jbeuckm/CR78-Controller/eagle/cr78_controller_layout.png

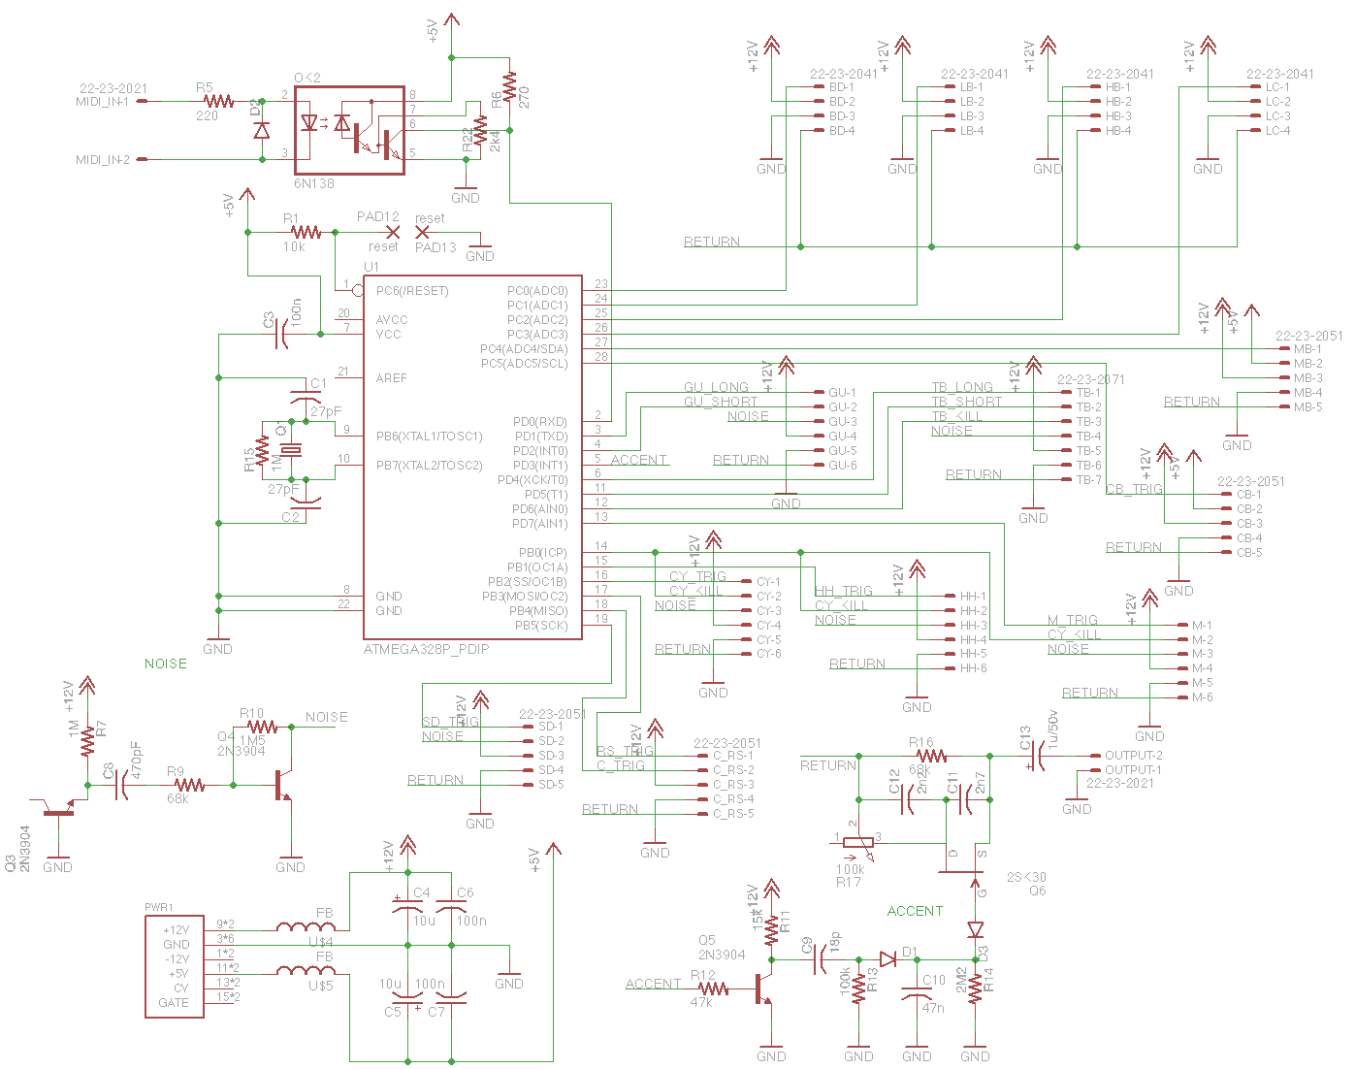
eagle/cr78_controller_layout.png
