jbeuckm/CR78-Controller/eagle/midi_to_cv.brd

## EAGLE design eagle/midi_to_cv.brd (2016-06-11)

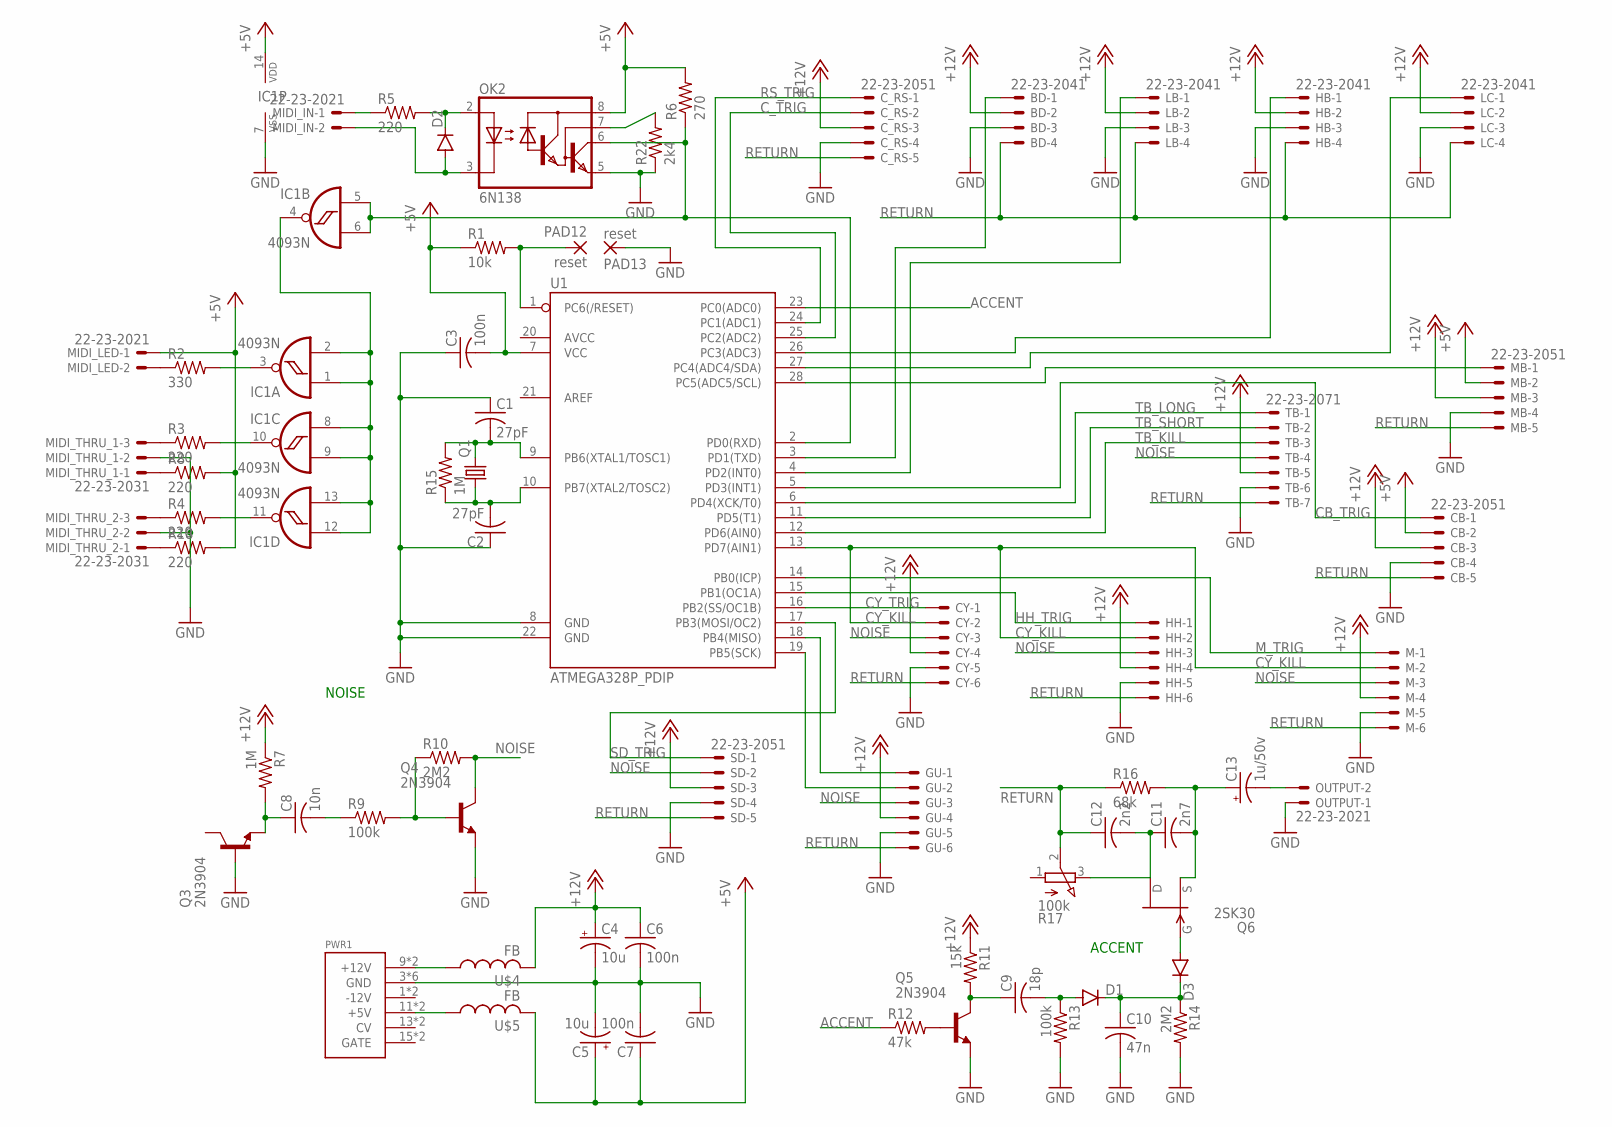
[picture p2: schematic midi_to_cv.sch]

Parts:
BD: 22-23-2041
C1, C2: 27pF; C025-040X050
C3: 100n; C025-040X050
C4, C5: 10u; B45181A
C6, C7: 100n; C050-024X044
C8: 10n; C025-040X050
C9: 18p; C050-025X075
C10: 47n; C025-040X050
C11: 2n7; C025-040X050
C12: 2n2; C025-040X050
C13: 1u/50v; B45181A
CB: 22-23-2051
CY: 22-23-2061
C_RS: 22-23-2051
D1: DIODEKIT; DIODE-1N4148-KIT
D2, D3: DIODE1N4148; DIODE-1N4148
GU: 22-23-2061
HB: 22-23-2041
HH: 22-23-2061
IC1: 4093N; DIL14
LB: 22-23-2041
LC: 22-23-2041
M: 22-23-2061
MB: 22-23-2051
MIDI_IN: 22-23-2021
MIDI_LED: 22-23-2021
MIDI_THRU_1, MIDI_THRU_2: 22-23-2031
OK2: 6N138; DIL08
OUTPUT: 22-23-2021
PAD12, PAD13: reset; 2,54/0,9
PWR1: POWER; POWER_16
Q1: CRYSTALHC49U-V; HC49U-V
Q3, Q4, Q5: 2N3904; TO92
Q6: 2SK30; TO92
R1: 10k; 0204/7
R2: 330; 0204/7
R3, R4, R5, R8, R18: 220; 0204/7
R6: 270; 0204/7
R7, R15: 1M; 0204/7
R9, R13: 100k; 0204/7
R10, R14: 2M2; 0204/7
R11: 15k; 0204/7
R12: 47k; 0207/12
R16: 68k; 0204/7
R17: 100k; 3RP/1610N
R22: 2k4; 0204/7
SD: 22-23-2051
TB: 22-23-2071
U1: ATMEGA328P_PDIP; DIL28-3
U$4, U$5: FB

Connections:
+5V: C3.2, C5.+, C7.1, CB.2, IC1.14 (VDD), MB.2, MIDI_LED.1, OK2.8 (VCC), R1.1, R6.2, R8.2, R18.2, U1.7 (VCC), U$5.P$2 (2)
+12V: BD.2, C4.+, C6.1, CB.3, CY.4, C_RS.3, GU.4, HB.2, HH.4, LB.2, LC.2, M.4, MB.3, R7.1, R11.1, SD.3, TB.5, U$4.P$2 (2)
ACCENT: R12.1, U1.23 (PC0(ADC0))
CB_TRIG: CB.1, U1.5 (PD3(INT1))
CY_KILL: CY.2, HH.2, M.2, U1.13 (PD7(AIN1))
CY_TRIG: CY.1, U1.16 (PB2(SS/OC1B))
C_TRIG: C_RS.2, U1.25 (PC2(ADC2))
GND: BD.3, C1.1, C2.1, C3.1, C4.-, C5.-, C6.2, C7.2, C10.2, CB.4, CY.5, C_RS.4, GU.5, HB.3, HH.5, IC1.7 (VSS), LB.3, LC.3, M.5, MB.4, MIDI_THRU_1.2, MIDI_THRU_2.2, OK2.5 (GND), OUTPUT.1, PAD13.1, PWR1.3 (GND), PWR1.4 (GND), PWR1.5 (GND), PWR1.6 (GND), PWR1.7 (GND), PWR1.8 (GND), Q3.2 (B), Q4.3 (E), Q5.3 (E), R13.2, R14.2, R22.1, SD.4, TB.6, U1.8 (GND), U1.22 (GND)
HH_TRIG: HH.1, U1.15 (PB1(OC1A))
M_TRIG: M.1, U1.14 (PB0(ICP))
unnamed: PAD12.1, R1.2, U1.1 (PC6(/RESET))
unnamed: PWR1.9 (+12V), PWR1.10 (+12V), U$4.P$1 (1)
unnamed: BD.1, U1.3 (PD1(TXD))
unnamed: C1.2, Q1.2, R15.2, U1.9 (PB6(XTAL1/TOSC1))
unnamed: C2.2, Q1.1, R15.1, U1.10 (PB7(XTAL2/TOSC2))
unnamed: C8.1, Q3.3 (E), R7.2
unnamed: LB.1, U1.4 (PD2(INT0))
unnamed: C8.2, R9.1
unnamed: GU.1, U1.18 (PB4(MISO))
unnamed: GU.2, U1.19 (PB5(SCK))
unnamed: IC1.5 (I0), IC1.6 (I1), OK2.6 (VO), R6.1, U1.2 (PD0(RXD))
unnamed: IC1.3 (O), R2.2
unnamed: Q4.2 (B), R9.2, R10.1
unnamed: HB.1, U1.26 (PC3(ADC3))
unnamed: C9.1, Q5.1 (C), R11.2
unnamed: Q5.2 (B), R12.2
unnamed: D2.A, MIDI_IN.2, OK2.3 (C)
unnamed: D2.C, OK2.2 (A), R5.2
unnamed: MIDI_IN.1, R5.1
unnamed: MIDI_THRU_1.1, R8.1
unnamed: C9.2, D1.A, R13.1
unnamed: C10.1, D1.C, D3.C, R14.1
unnamed: D3.A, Q6.2 (G)
unnamed: MB.1, U1.28 (PC5(ADC5/SCL))
unnamed: LC.1, U1.27 (PC4(ADC4/SDA))
unnamed: C13.-, OUTPUT.2
unnamed: IC1.10 (O), R3.2
unnamed: IC1.11 (O), R4.2
unnamed: C11.1, C12.2, Q6.1 (D), R17.3 (E)
unnamed: IC1.1 (I0), IC1.2 (I1), IC1.4 (O), IC1.8 (I0), IC1.9 (I1), IC1.12 (I0), IC1.13 (I1)
unnamed: MIDI_LED.2, R2.1
unnamed: C11.2, C13.+, Q6.3 (S), R16.2
unnamed: MIDI_THRU_1.3, R3.1
unnamed: MIDI_THRU_2.3, R4.1
unnamed: MIDI_THRU_2.1, R18.1
unnamed: OK2.7 (VB), R22.2
unnamed: PWR1.11 (+5V), PWR1.12 (+5V), U$5.P$1 (1)
NOISE: CY.3, GU.3, HH.3, M.3, Q4.1 (C), R10.2, SD.2, TB.4
RETURN: BD.4, C12.1, CB.5, CY.6, C_RS.5, GU.6, HB.4, HH.6, LB.4, LC.4, M.6, MB.5, R16.1, R17.2 (S), SD.5, TB.7
RS_TRIG: C_RS.1, U1.24 (PC1(ADC1))
SD_TRIG: SD.1, U1.17 (PB3(MOSI/OC2))
TB_KILL: TB.3, U1.12 (PD6(AIN0))
TB_LONG: TB.1, U1.6 (PD4(XCK/T0))
TB_SHORT: TB.2, U1.11 (PD5(T1))

Notes on the sheet:
NOISE
ACCENT

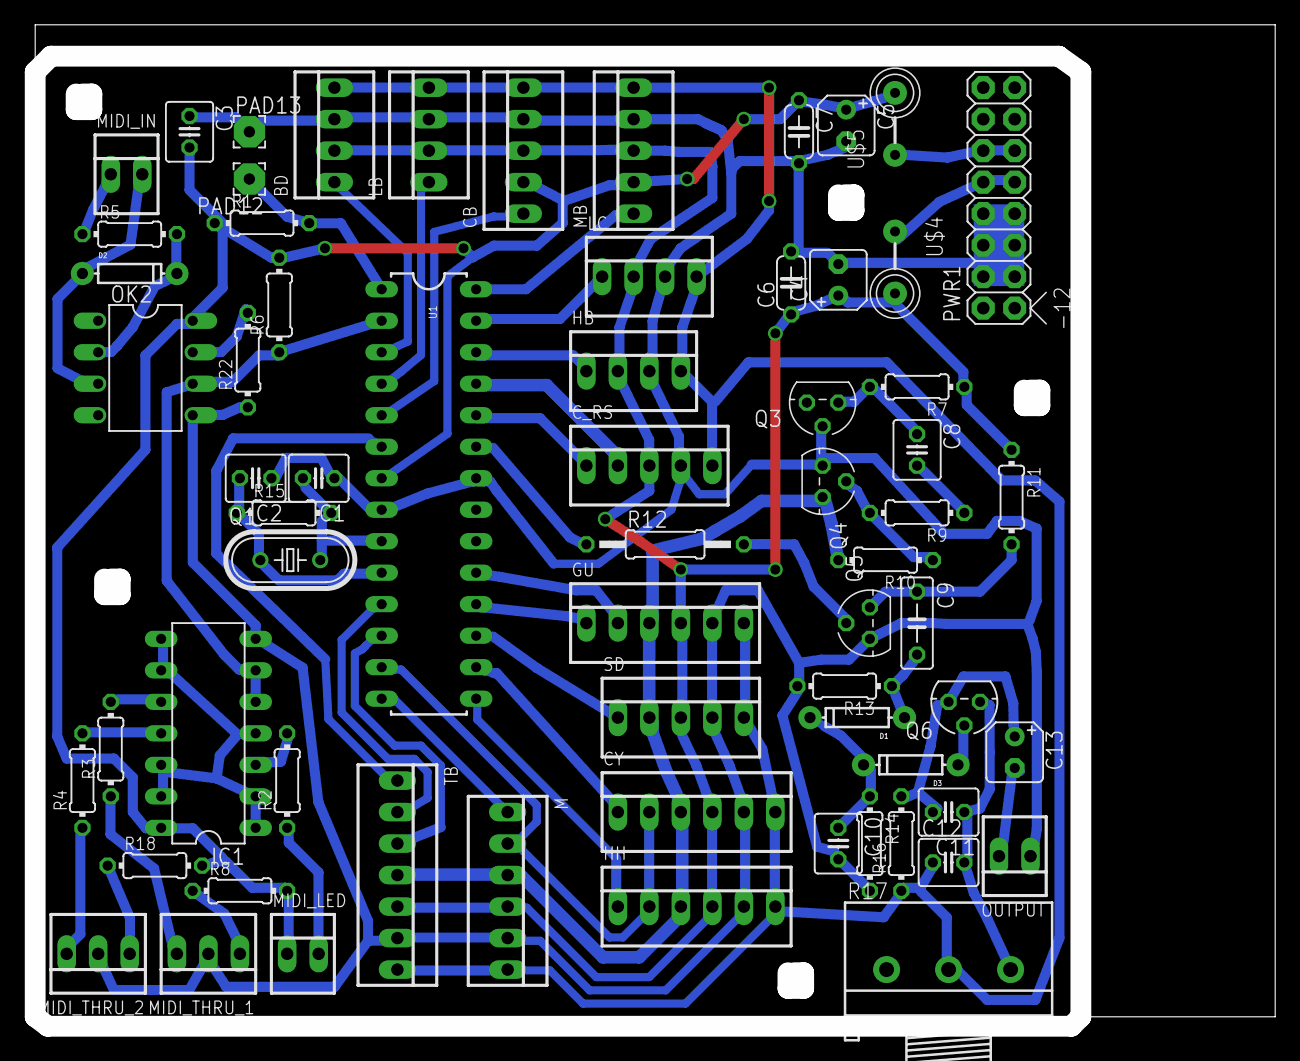
[picture p3: board midi_to_cv.brd from above]

Board: 2 copper layers, 100.0 x 80.8 mm, 66 parts (0 on the bottom side), 54 nets.
