jbeuckm/CR78-Controller/(commit log)

2016-05-25 basic midi atmega circuit
    [midi_to_cv.brd, midi_to_cv.sch]
2016-05-25 noise and accent and raw gates
    [midi_to_cv.brd, midi_to_cv.sch]
2016-06-06 connectors for each voice
    [midi_to_cv.brd, midi_to_cv.sch]
2016-06-07 close to routed
    [midi_to_cv_vs.brd, midi_to_cv_vs.sch]
2016-06-07 95pct auto
    [midi_to_cv.brd, midi_to_cv.sch, midi_to_cv_vs.brd, midi_to_cv_vs.sch]
2016-06-07 added midi led and thru
    [midi_to_cv.brd, midi_to_cv.sch]
2016-06-07 shifted accent pin closer to circuit
    [midi_to_cv.brd, midi_to_cv.sch]
2016-06-08 tweaks toward auto
    [midi_to_cv.brd, midi_to_cv.sch]
2016-06-08 96pct auto
    [midi_to_cv.brd, midi_to_cv.sch]
2016-06-08 97pct auto
    [midi_to_cv.brd]
2016-06-11 arduino code compiles
    [midi_to_cv.brd, midi_to_cv.sch]
2016-06-11 bd not working, others seem fine
    [MIDI_CR78.ino]
2016-10-23 SoftwareSerialIn as included library and accent depends on velocity
